jgruen2/Counter/BOM.xlsx

Column1 | Column2 | Column3 | Column4 | Column5
Reference | Value | Footprint | Datasheet | Cost
U4 | 74LS47 | 1_Jons_Footprints:SN74LS47D - SOIC127P600X175-16N | http://www.ti.com/lit/gpn/sn74LS47 | 1.77
R7 | 3.3k | Resistor_SMD:R_0603_1608Metric | ~ | 0.1
R6 | 3.3k | Resistor_SMD:R_0603_1608Metric | ~ | 0.1
R5 | 3.3k | Resistor_SMD:R_0603_1608Metric | ~ | 0.1
R4 | 3.3k | Resistor_SMD:R_0603_1608Metric | ~ | 0.1
R3 | 3.3k | Resistor_SMD:R_0603_1608Metric | ~ | 0.1
R2 | 3.3k | Resistor_SMD:R_0603_1608Metric | ~ | 0.1
R1 | 3.3k | Resistor_SMD:R_0603_1608Metric | ~ | 0.1
U5 | 74LS90 | 1_Jons_Footprints:SN74LS90DR - SOIC127P600X175-14N | http://www.ti.com/lit/gpn/sn74LS90 | 2.25
SW1 | SW_Push | 1_Jons_Footprints:Push Button - 1241.1601.11 | https://us.schurter.com/bundles/snceschurter/epim/_ProdPool_/newDS/en/typ_SMS.pdf | 0.31
R19 | 10k | Resistor_SMD:R_0603_1608Metric | ~ | 0.02
U12 | HDSP-A151 | Display_7Segment:HDSP-A151 | https://docs.broadcom.com/docs/AV02-2553EN | 3.25
U10 | 74LS47 | 1_Jons_Footprints:SN74LS47D - SOIC127P600X175-16N | http://www.ti.com/lit/gpn/sn74LS47 | 1.77
R14 | 3.3k | Resistor_SMD:R_0603_1608Metric | ~ | 0.23
R13 | 3.3k | Resistor_SMD:R_0603_1608Metric | ~ | 0.23
R12 | 3.3k | Resistor_SMD:R_0603_1608Metric | ~ | 0.23
R11 | 3.3k | Resistor_SMD:R_0603_1608Metric | ~ | 0.23
R10 | 3.3k | Resistor_SMD:R_0603_1608Metric | ~ | 0.23
R9 | 3.3k | Resistor_SMD:R_0603_1608Metric | ~ | 0.23
R8 | 3.3k | Resistor_SMD:R_0603_1608Metric | ~ | 0.23
U11 | 74LS90 | 1_Jons_Footprints:SN74LS90DR - SOIC127P600X175-14N | http://www.ti.com/lit/gpn/sn74LS90 | 2.25
U9 | HDSP-A151 | Display_7Segment:HDSP-A151 | https://docs.broadcom.com/docs/AV02-2553EN | 3.25
R20 | 10k | Resistor_SMD:R_0603_1608Metric | ~ | 0.02
C3 | 0.1uF | Capacitor_SMD:C_0603_1608Metric | ~ | 0.03
R18 | 10k | Resistor_SMD:R_0603_1608Metric | ~ | 0.02
C2 | 0.1uF | Capacitor_SMD:C_0603_1608Metric | ~ | 0.03
R17 | 10k | Resistor_SMD:R_0603_1608Metric | ~ | 0.02
SW2 | SW_Push | 1_Jons_Footprints:Push Button - 1241.1601.11 | https://us.schurter.com/bundles/snceschurter/epim/_ProdPool_/newDS/en/typ_SMS.pdf | 0.31
R16 | 100k | Resistor_SMD:R_0603_1608Metric | ~ | 0.15
Q1 | BSS138 | Package_TO_SOT_SMD:SOT-23 | https://www.fairchildsemi.com/datasheets/BS/BSS138.pdf | 0.26
R15 | 10k | Resistor_SMD:R_0603_1608Metric | ~ | 0.02
C1 | 0.1uF | Capacitor_SMD:C_0603_1608Metric | ~ | 0.03
TP1 | TestPoint | TestPoint:TestPoint_Pad_D1.0mm | ~ | 0
TP2 | TestPoint | TestPoint:TestPoint_Pad_D1.0mm | ~ | 0
TP3 | TestPoint | TestPoint:TestPoint_Pad_D1.0mm | ~ | 0
H2 | MountingHole_Pad | MountingHole:MountingHole_2.5mm_Pad | ~ | 0
H1 | MountingHole_Pad | MountingHole:MountingHole_2.5mm_Pad | ~ | 0
H3 | MountingHole_Pad | MountingHole:MountingHole_2.5mm_Pad | ~ | 0
H4 | MountingHole_Pad | MountingHole:MountingHole_2.5mm_Pad | ~ | 0
C9 | 0.1uF | Capacitor_SMD:C_0603_1608Metric | ~ | 0.03
C14 | 0.1uF | Capacitor_SMD:C_0603_1608Metric | ~ | 0.03
C10 | 0.1uF | Capacitor_SMD:C_0603_1608Metric | ~ | 0.03
C11 | 0.1uF | Capacitor_SMD:C_0603_1608Metric | ~ | 0.03
C12 | 0.1uF | Capacitor_SMD:C_0603_1608Metric | ~ | 0.03
C13 | 0.1uF | Capacitor_SMD:C_0603_1608Metric | ~ | 0.03
C20 | 0.1uF | Capacitor_SMD:C_0603_1608Metric | ~ | 0.03
TP6 | TestPoint | TestPoint:TestPoint_Pad_D1.0mm | ~ | 0
TP5 | TestPoint | TestPoint:TestPoint_Pad_D1.0mm | ~ | 0
TP4 | TestPoint | TestPoint:TestPoint_Pad_D1.0mm | ~ | 0
R35 | 100k | Resistor_SMD:R_0603_1608Metric | ~ | 0.15
R36 | 100k | Resistor_SMD:R_0603_1608Metric | ~ | 0.15
S1 | JS102011SAQN | 1_Jons_Footprints:SW_JS102011SAQN | https://dznh3ojzb2azq.cloudfront.net/products/Slide/JS/documents/datasheet.pdf | 1.41
Q2 | MMUN2133LT1G | 1_Jons_Footprints:SOT95P240X111-3N | https://www.onsemi.com/pub/Collateral/DTA143Z-D.PDF | 0.12
L1 | 6.8uH | 1_Jons_Footprints:SD43-562 | https://www.mouser.com/datasheet/2/597/sd43-774587.pdf
R34 | 1k | Resistor_SMD:R_0603_1608Metric | ~ | 0.02
C6 | 0.1uF | Capacitor_SMD:C_0603_1608Metric | ~ | 0.03
C5 | 10uF | Capacitor_SMD:C_0603_1608Metric | ~ | 0.13
C8 | 100uF | Capacitor_SMD:C_0603_1608Metric | ~ | 0.76
C7 | 2.2uF | Capacitor_SMD:C_0603_1608Metric | ~ | 0.14
U22 | MCP73871 | Package_DFN_QFN:QFN-20-1EP_4x4mm_P0.5mm_EP2.5x2.5mm | http://www.mouser.com/ds/2/268/22090a-52174.pdf | 1.79
R21 | 1k | Resistor_SMD:R_0603_1608Metric | ~ | 0.02
D2 | LED | 1_Jons_Footprints:LTST-C193KGKT-5A - 0603 | https://vcclite.com/wp-content/uploads/wpallimport/files/files/LSM0603453V.pdf | 0.29
D1 | LED | 1_Jons_Footprints:LTST-C193KGKT-5A - 0603 | https://vcclite.com/wp-content/uploads/wpallimport/files/files/LSM0603453V.pdf | 0.29
U25 | Header | 1_Jons_Footprints:Battery Header |  | 0
C4 | 10uF | Capacitor_SMD:C_0603_1608Metric | ~ | 0.13
R22 | 1k | Resistor_SMD:R_0603_1608Metric | ~ | 0.02
R24 | 1k | Resistor_SMD:R_0603_1608Metric | ~ | 0.02
R27 | 100k | Resistor_SMD:R_0603_1608Metric | ~ | 0.15
R25 | 270k | Resistor_SMD:R_0603_1608Metric | ~ | 0.17
R28 | 16k | Resistor_SMD:R_0603_1608Metric | ~ | 0.34
D4 | LED | 1_Jons_Footprints:LTST-C193KGKT-5A - 0603 | https://vcclite.com/wp-content/uploads/wpallimport/files/files/LSM0603453V.pdf | 0.29
R30 | 340k | Resistor_SMD:R_0603_1608Metric | ~ | 0.11
R29 | 1.87M | Resistor_SMD:R_0603_1608Metric | ~ | 0.11
R23 | 100k | Resistor_SMD:R_0603_1608Metric | ~ | 0.15
R33 | 1k | Resistor_SMD:R_0603_1608Metric | ~ | 0.02
R31 | 1.07M | Resistor_SMD:R_0603_1608Metric | ~ | 0.11
R32 | 200k | Resistor_SMD:R_0603_1608Metric | ~ | 0.34
D3 | LED | 1_Jons_Footprints:LTST-C193KGKT-5A - 0603 | https://vcclite.com/wp-content/uploads/wpallimport/files/files/LSM0603453V.pdf | 0.29
R26 | 100k | Resistor_SMD:R_0603_1608Metric | ~ | 0.15
U27 | TPS61090 | Package_DFN_QFN:Texas_S-PVQFN-N16_EP2.7x2.7mm_ThermalVias | http://www.ti.com/lit/ds/symlink/tps61090.pdf | 2.34
J1 | MicroUSB | 1_Jons_Footprints:FCI_10118193-0001LF | https://cdn.amphenol-icc.com/media/wysiwyg/files/documentation/datasheet/inputoutput/io_usb_micro.pdf | 0.43
