jgruen2/Counter/backup 3-18-30/CounterProject/CounterProject.kicad_pcb

## KiCad design backup 3-18-30/CounterProject/CounterProject.kicad_pcb (2020-07-11)

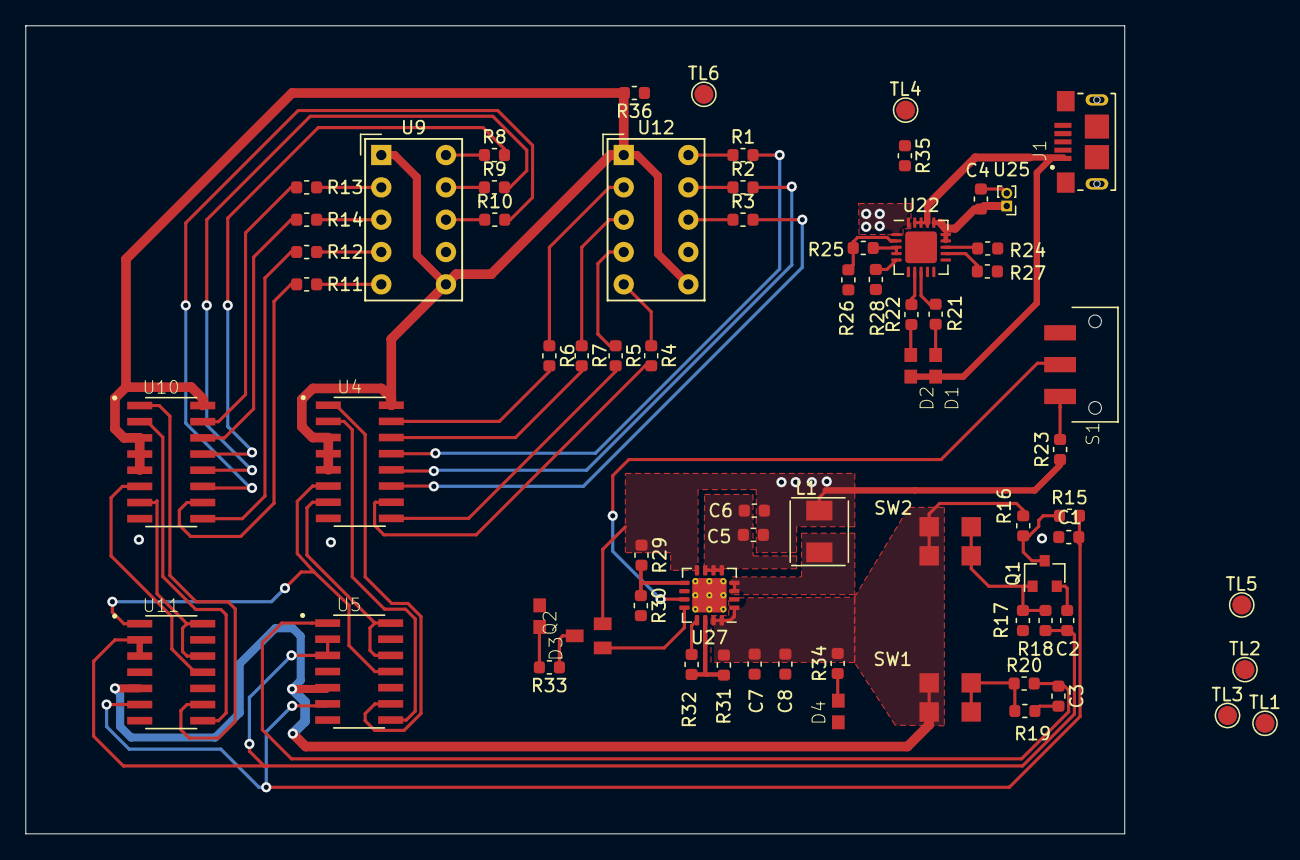
[picture p1: board CounterProject.kicad_pcb from above]

Board: 2 copper layers, 86.4 x 63.5 mm, 70 parts (0 on the bottom side), 64 nets.

Parts:
C1, C2, C3, C6: 0.1uF; C_0603_1608Metric
C4, C5: 10uF; C_0603_1608Metric
C7: 2.2uF; C_0603_1608Metric
C8: 100uF; C_0603_1608Metric
D1, D2, D3, D4: LED; LTST-C193KGKT-5A - 0603
J1: USB_B_Micro; FCI_10118193-0001LF
L1: 6.8uH; SD43-562
Q1: BSS138; SOT-23
Q2: MMUN2133LT1G; SOT95P240X111-3N
R1, R2, R3, R4, R5, R6, R7, R8, R9, R10, R11, R12, R13, R14: 3.3k; R_0603_1608Metric
R15, R17, R18, R19, R20: 10k; R_0603_1608Metric
R16, R23, R26, R27, R35, R36: 100k; R_0603_1608Metric
R21, R22, R24, R33, R34: 1k; R_0603_1608Metric
R25: 270k; R_0603_1608Metric
R28: 16k; R_0603_1608Metric
R29: 1.87M; R_0603_1608Metric
R30: 340k; R_0603_1608Metric
R31: 1.07M; R_0603_1608Metric
R32: 200k; R_0603_1608Metric
S1: JS102011SAQN; SW_JS102011SAQN
SW1, SW2: SW_Push; Push Button - 1241.1601.11
TL1, TL2, TL3, TL4, TL5, TL6: TestLoop; TestPoint_Pad_D1.5mm
U4, U10: 74LS47; SN74LS47D - SOIC127P600X175-16N
U5, U11: 74LS90; SN74LS90DR - SOIC127P600X175-14N
U9, U12: HDSP-A151
U22: MCP73871; QFN-20-1EP_4x4mm_P0.5mm_EP2.5x2.5mm
U25: Header; PinHeader_1x02_P1.00mm_Vertical
U27: TPS61090; Texas_S-PVQFN-N16_EP2.7x2.7mm_ThermalVias

Connections:
+5V: C7.1, C8.1, R16.2, R31.1, R34.2, R36.2, SW1.2, SW2.2, U4.3, U4.4, U4.5, U4.16, U5.5, U9.1, U9.6, U10.3, U10.4, U10.5, U10.16, U11.5, U12.1, U12.6, U27.1, U27.15, U27.16
+BATT: C5.1, C6.1, L1.1, Q2.2, R23.1, R29.1, R35.2, U22.1, U22.20, U27.8
/A1: U4.7, U5.12, U5.14
/A2: U10.7, U11.12, U11.14
/B1: U4.1, U5.9
/B2: U10.1, U11.9
/C1: U4.2, U5.8
/C2: U10.2, U11.8
/D1: U4.6, U5.11, U11.1
/D2: U10.6, U11.11
/Power/EN: S1.2, U27.11
/Push: C3.1, R20.2, U5.1
/Reset: C2.1, R18.2, U5.2, U5.3, U11.2, U11.3
/Reset_GND: C1.1, R15.2, U5.6, U11.6
GND: C1.2, C2.2, C3.2, C4.2, C5.2, C6.2, C7.2, C8.2, D3.1, D4.1, J1.5, Q1.2, R17.2, R19.2, R24.2, R26.2, R27.2, R28.2, R30.2, R32.2, S1.3, U4.8, U5.10, U10.8, U11.10, U22.10, U22.11, U22.21, U25.2, U27.5, U27.6, U27.7, U27.10, U27.13, U27.17
unnamed: C4.1, U22.14, U22.15, U22.16, U25.1
unnamed: D1.1, R21.1
unnamed: D2.1, R22.1
unnamed: D3.2, R33.2
unnamed: D4.2, R34.1
unnamed: L1.2, U27.3, U27.4
unnamed: Q1.1, R17.1, R18.1, SW2.1
unnamed: Q1.3, R15.1, R16.1
unnamed: Q2.1, U27.12
unnamed: Q2.3, R33.1
unnamed: R1.1, U12.10
unnamed: R1.2, U4.13
unnamed: R2.1, U12.9
unnamed: R2.2, U4.12
unnamed: R3.1, U12.8
unnamed: R3.2, U4.11
unnamed: R4.1, U12.5
unnamed: R4.2, U4.10
unnamed: R5.1, U12.4
unnamed: R5.2, U4.9
unnamed: R6.1, U12.2
unnamed: R6.2, U4.15
unnamed: R7.1, U12.3
unnamed: R7.2, U4.14
unnamed: R8.1, U9.10
unnamed: R8.2, U10.13
unnamed: R9.1, U9.9
unnamed: R9.2, U10.12
unnamed: R10.1, U9.8
unnamed: R10.2, U10.11
unnamed: R11.1, U9.5
unnamed: R11.2, U10.10
unnamed: R12.1, U9.4
unnamed: R12.2, U10.9
unnamed: R13.1, U9.2
unnamed: R13.2, U10.15
unnamed: R14.1, U9.3
unnamed: R14.2, U10.14
unnamed: R19.1, R20.1, SW1.1
unnamed: R21.2, U22.8
unnamed: R22.2, U22.7
unnamed: R23.2, S1.1
unnamed: R24.1, U22.13
unnamed: R25.2, R26.1, U22.2
unnamed: R27.1, U22.12
unnamed: R28.1, U22.5
unnamed: R29.2, R30.1, U27.9
unnamed: R31.2, R32.1, U27.14
VBUS: D1.2, D2.2, J1.1, R25.1, U22.3, U22.4, U22.9, U22.17, U22.18, U22.19
